glasgowneuro/attys_hw/README.md

# Attys Hardware design

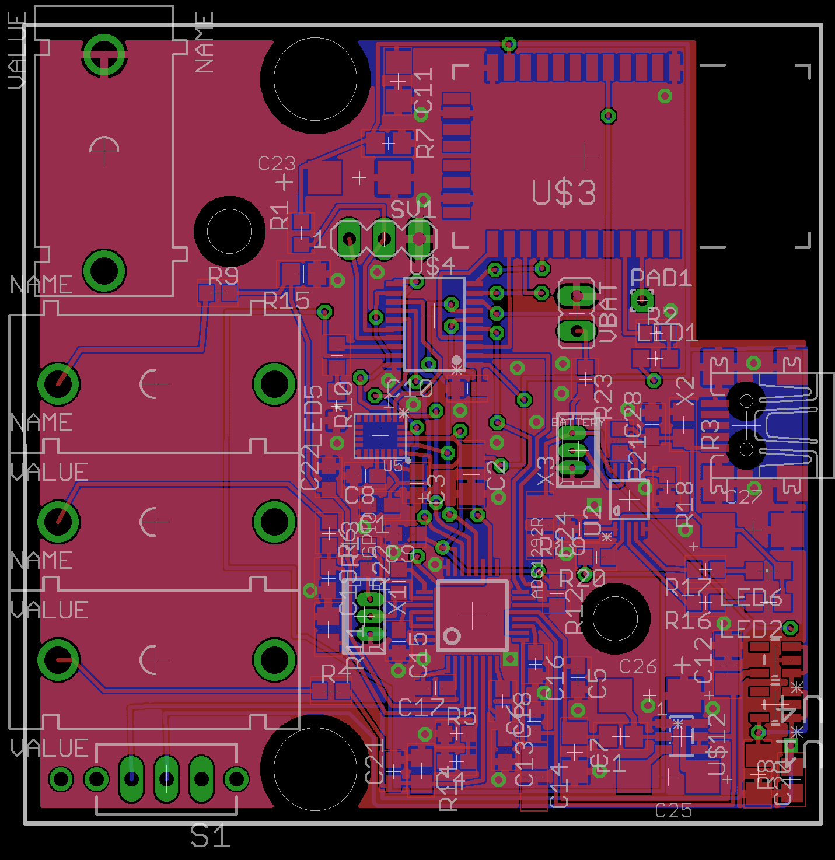
[picture p1: topview.png]


The PCB has been designed with EAGLE.

Copyright 2016 Glasgow Neuro LTD & Bernd Porr
