glasgowneuro/attys_hw/(commit log)

2023-08-15 Current version being sold
    [bt_bio.brd, bt_bio.sch, bt_bio_bom.ods, bt_bio_bom.xls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]
2025-09-10 Renamed to be consistent
    [attys.brd, attys.sch, attys_bom.xls, bt_bio.brd, bt_bio.sch, bt_bio_bom.ods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]
2025-09-10 Added license
    [bt_bio.brd, bt_bio.sch, bt_bio_bom.ods, bt_bio_bom.xls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]
